Breschdling/PI3CM/BOM/BOM.xls

Designator | Value | Quantity | Manufacturer | Part No.: | Mouser PN | Footprint
C7 | 220uF/16V | 1 | Nichicon | RL81C221MDN1KX | 647-RL81C221MDN1KX | 8x8P3,5
C11,12,13,15,16,17,18,20,21,22,31,32,33,34,35,36,37,38 | 22uF | 18 | Murata | GRM21BR61A226ME51L | 81-GRM21BR61A226ME1L | 0805
C1,3,5,10,27 | 10uF | 5 | Murata | GRM21BR61C106KE15K | 81-GRM21BR61C106KE5K | 0805
C2,8,19,23,40 | 2.2uF | 5 | Murata | GRM21BR71A225KA01K | 81-GRM21BR71A225KA1K | 0805
C4,9,26,28,29,30 | 100nF | 6 | Murata | GRM188R71H104KA93D | 81-GRM39X104K50D | 0603
C6,14 | 10nF | 2 | Murata | GRM188R71H103KA01D | 81-GRM39X103K50D | 0603
C24,25 | 33pF | 2 | Murata | GRM1885C1H330JA01D | 81-GRM39C330J50 | 0603
C39 | 4n7 | 1 | Murata | GRM21AR72D472KW01D | 81-GRM21AR72D472KW1D | 0805
R15,16,24 | 0R | 3 | Panasonic | ERJ-3GEY0R00V | 667-ERJ-3GEY0R00V | 0603
R17,18 | 50mR | 2 | Susumu | RL1220T-R050-G | 754-RL1220T-R050-G | 0805
R22,23,29,30,31,32,33,34,35,36 | 22R | 10 | Bourns | CR0603-FX-22R0ELF | 652-CR0603FX-22R0ELF | 0603
R2 | 100R | 1 | Bourns | CR0603-FX-1000ELF | 652-CR0603FX-1000ELF | 0603
R7 | 470R | 1 | Bourns | CR0603-FX-4700ELF | 652-CR0603FX-4700ELF | 0603
R25,37,43,44 | 1k5 | 4 | Bourns | CR0603-FX-1501ELF | 652-CR0603FX-1501ELF | 0603
R10,12,20 | 10k | 3 | Bourns | CR0603-FX-1002ELF | 652-CR0603FX-1002ELF | 0603
R6,8 | 30k | 2 | Bourns | CR0603-FX-3002ELF | 652-CR0603FX-3002ELF | 0603
R11 | 33k2 | 1 | Bourns | CR0603-FX-3322ELF | 652-CR0603FX-3322ELF | 0603
R13,14 | 68k | 2 | Bourns | CR0603-FX-6802ELF | 652-CR0603FX-6802ELF | 0603
R1,3,4,5,9,19,21,26,27,28,38,39,40,41,42 | 100k | 15 | Bourns | CR0603-FX-1003ELF | 652-CR0603-FX-103ELF | 0603
R45 | 0R47 | 1 | TE con | 2-2176054-4 | 279-2-2176054-4 | 0805
R46 | 2R7 | 1 | Panasonic | ERJ-3GEYJ2R7V | 667-ERJ-3GEYJ2R7V | 0603
L1,2 | 2.2uH | 2 | Tayo Yuden | NS10165T2R2NNV | 963-NS10165T2R2NNV | 10,1x10,1
Y1 | 6MHz | 1 | Epson | CA-301 6.000M-C:PBFREE | 732-CA3016.000M-CPB | Radial
T1 | Si3421DV | 1 | Vishay | SI3421DV-T1-GE3 | 78-SI3421DV-T1-GE3 | TSOP-6
T2,4,5,6,7 | 2N7002 | 5 | Fairchild | 2N7002KW | 512-2N7002KW | SOT-323-3
D1 | SMBJ5.0CA | 1 | ST micro | SMBJ5.0CA | 511-SMBJ5.0CA | SMB
D2 | BAT54C | 1 | Fairchild | BAT54CWT1G | 512-BAT54CWT1G | SOT-323
D3 | SBR3U20SA | 1 | Diodes | SBR3U20SA-13 | 621-SBR3U20SA-13 | SMA-2
D4 | RB095BM-30 | 1 | Rohm | RB095BM-30TL | 755-RB095BM-30TL | TO-252-3
D5 | 82402305 | 1 | Wuerth | 82402305 | 710-82402305 | SOT-23-6L
IC1 | AP7361C-25ER | 1 | Diodes | AP7361C-25E-13
IC3 | AP7361C-18ER | 1 | Diodes | AP7361C-18E-13
IC2 | TPS563219A | 1 | Texas Instr. | TPS563219ADDFR | 595-TPS563219ADDFR | SOT-23-8
IC4 | ACT2813 | 1 | Active Semi | ACT2813QY-T | 107-ACT2813QY-T | QFN-20
IC5 | TUSB2046B | 1 | Texas Instr. | TUSB2046BVFRG4 | 595-TUSB2046BVFRG4 | LQFP-32
IC6 | AP2331 | 1 | Diodes | AP2331SA-7 | 621-AP2331SA-7 | SOT23-3
IC7 | TPS2044B | 1 | Texas Instr. | TPS2044BDR | 595-TPS2044BDR | SOIC-16
F1 | MF-MSMF250/16X | 1 | Bourns | MF-MSMF260 | 652-MF-MSMF260-2 | 1812
J1,3 | PH2x1_2.54 | 2 | 3M | 961102-6404-AR
J2 | PH3x1_2.54 | 1 | 3M | 961103-6404-AR
X1 | DDR2_SODIMM | 1 | TE con | 1473005-4 | 571-1473005-4 | DDR-SODIMM
X2 | PH20x2_2.54 | 1 | Omron | XG8W-2041
X3 | PH2x8_2.54 | 1 | Omron | XG8W-1641
X4 | PH5x1_2.54 | 1 | 3M | 961105-6404-AR
X5 | PH7x1_2.54 | 1 | 3M | 961107-6404-AR
X6,7 | PH2x1_2.54 | 2 | 3M | 961102-6404-AR
X9 | PH9x1_2.54 female | 1 | Harwin | M20-7820942 | 855-M20-7820942
X8,11,12,13,14 | PH4x1_2.54 | 5 | 3M | 961104-6404-AR
X10 | FFC pitch | 1 | Omron | XF2L-2035-1A | 653-XF2L-2035-1A
M1 | RPI3_CM_lite | 1 | Raspberry Pi | RPI-COMPUTE3-LT |  | DDR-SODIMM
