Breschdling/PI3CM/Schema/PI3CM.pdf

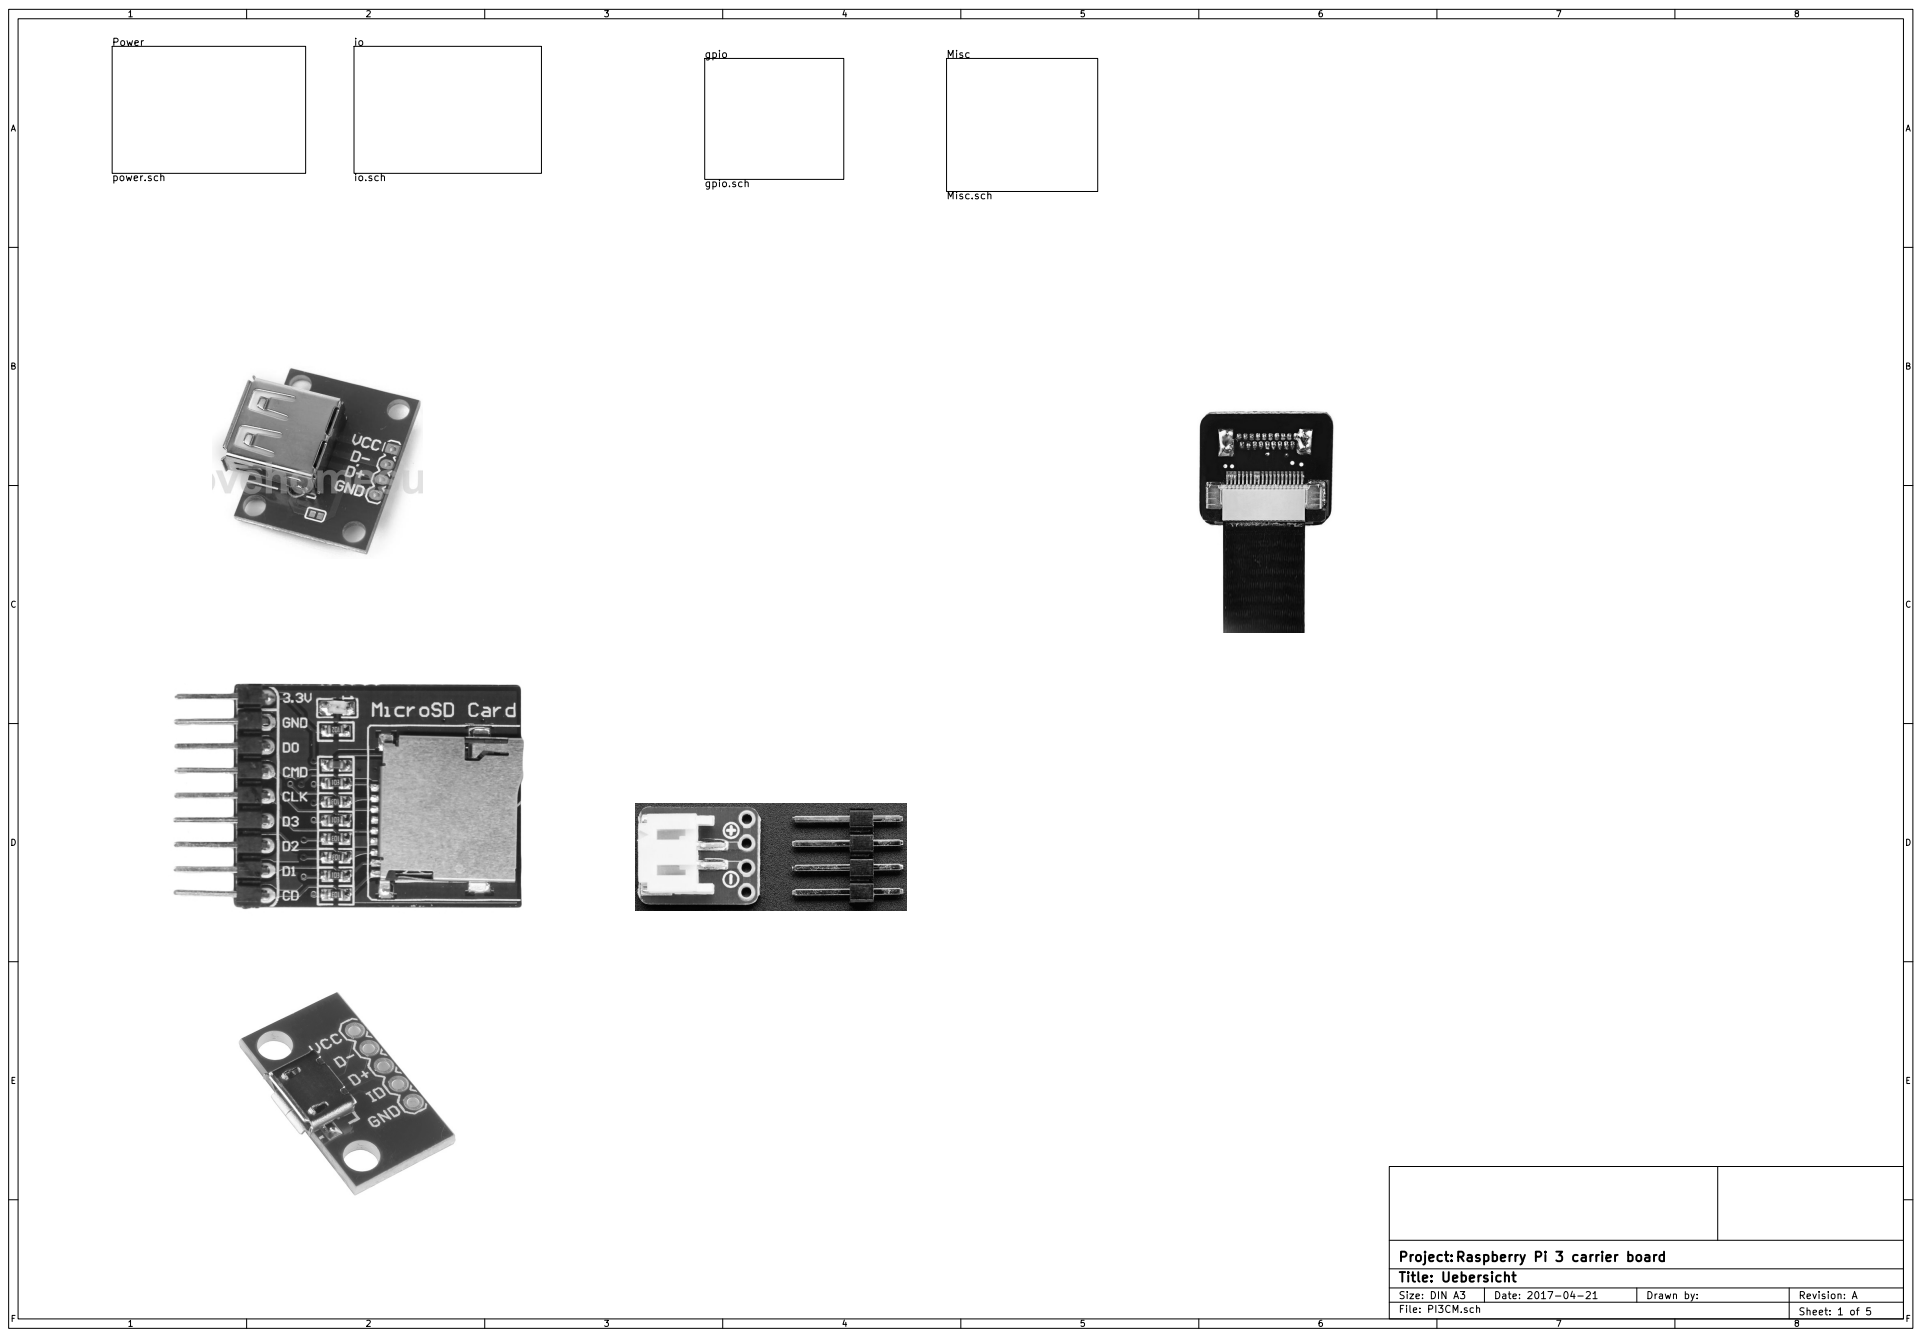
[picture p1: page 1]

Tobias Fetsch Sheet: 1 of 5 Title: Uebersicht File: PI3CM.sch Project:

Date: 2017-04-21 | Revision: A | F Size: DIN A3

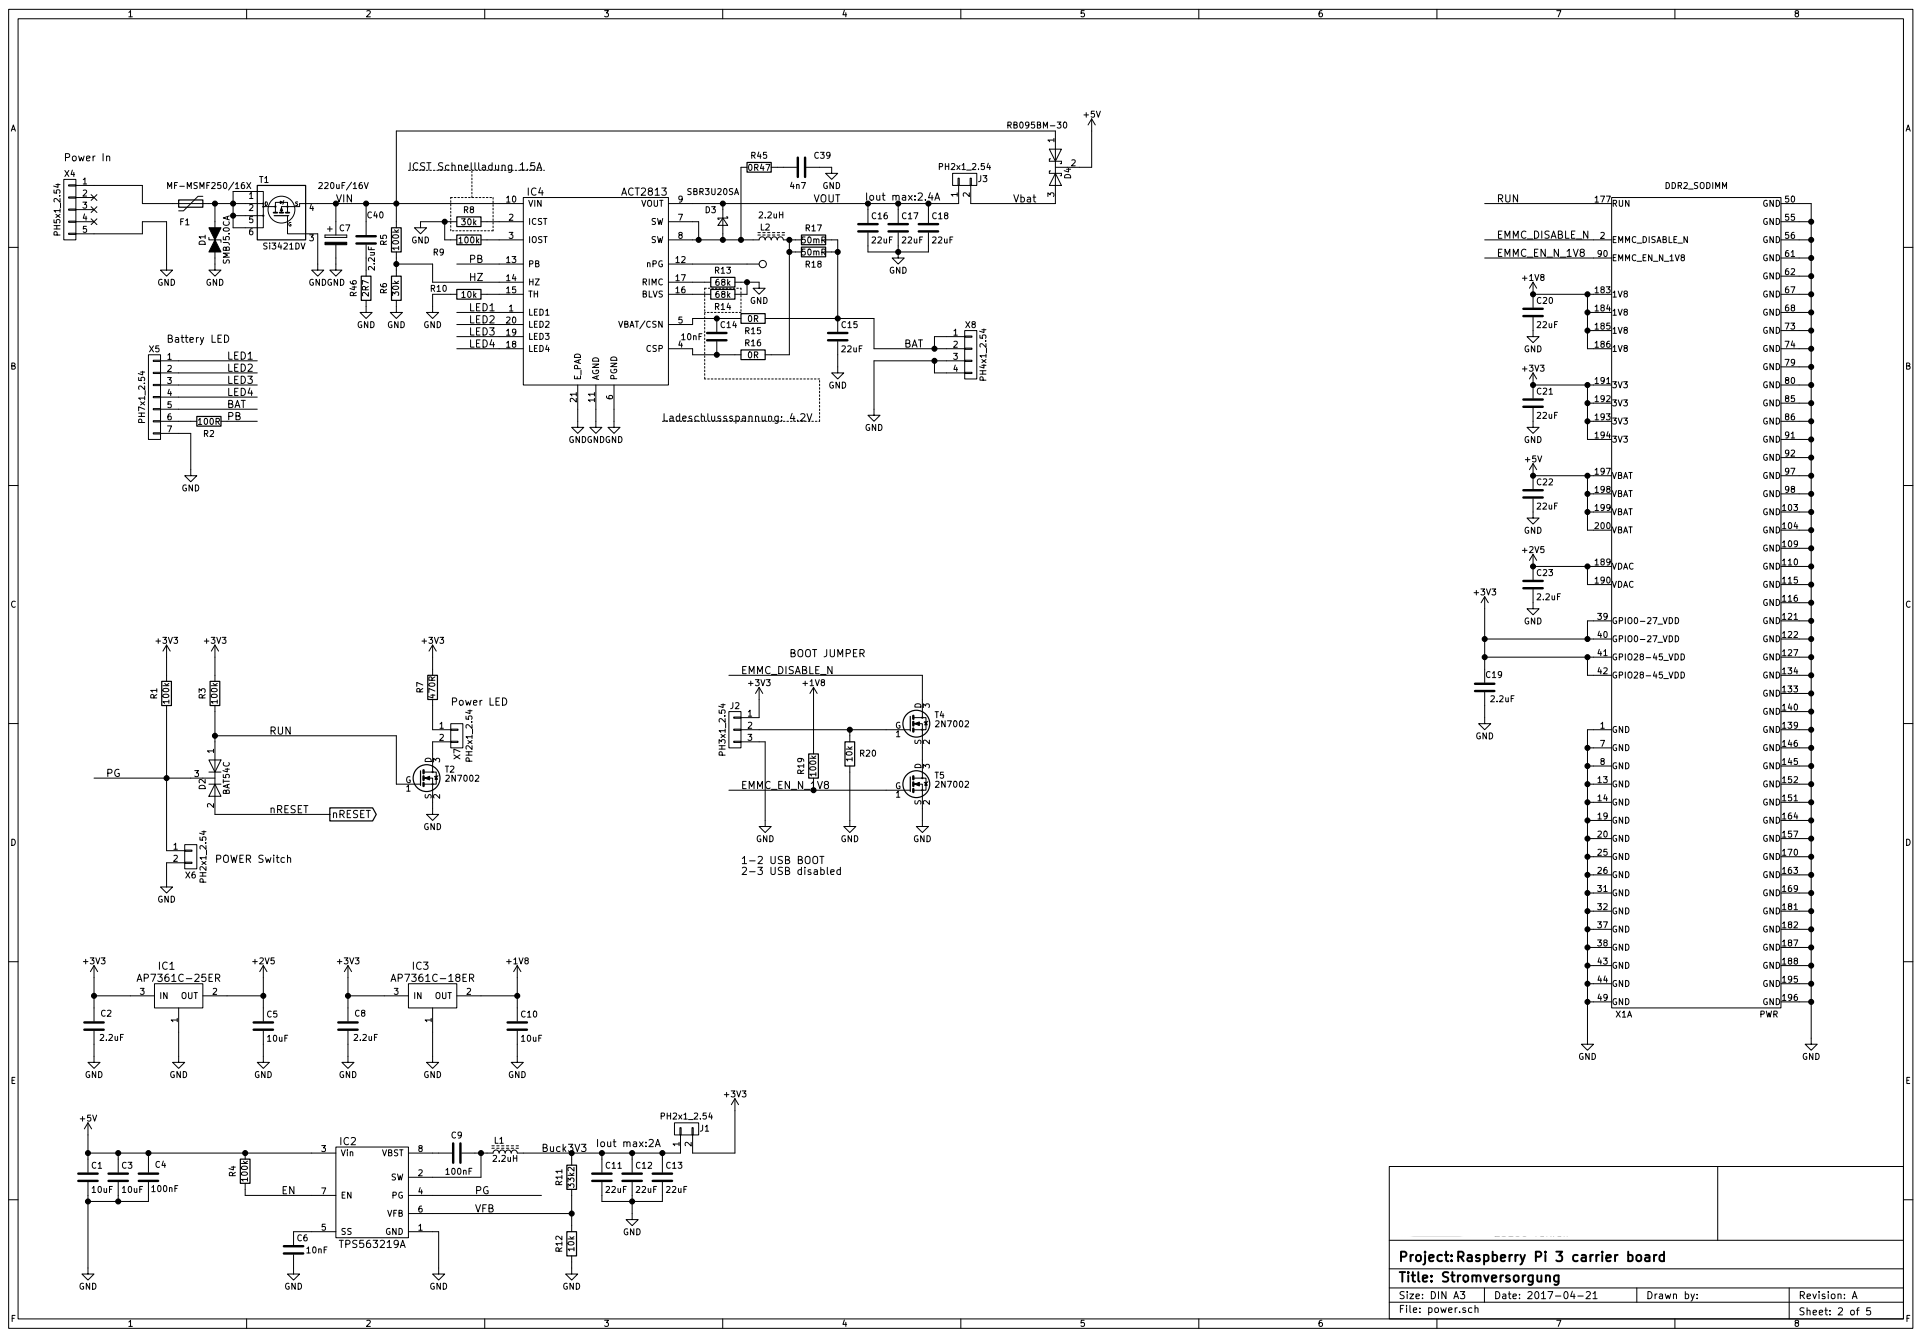
[picture p2: page 2]

6 SW 7 SW 8 VOUT 9 VIN 10

4 | 2 | 4 | | ICST 2 | R17

EMMC_EN_N_1V8 EMMC_DISABLE_N
22uF GND GND GND GND

IC2 TPS563219A | C11

File: power.sch Project: | Tobias Fetsch

Sheet: 2 of 5 Title: Stromversorgung

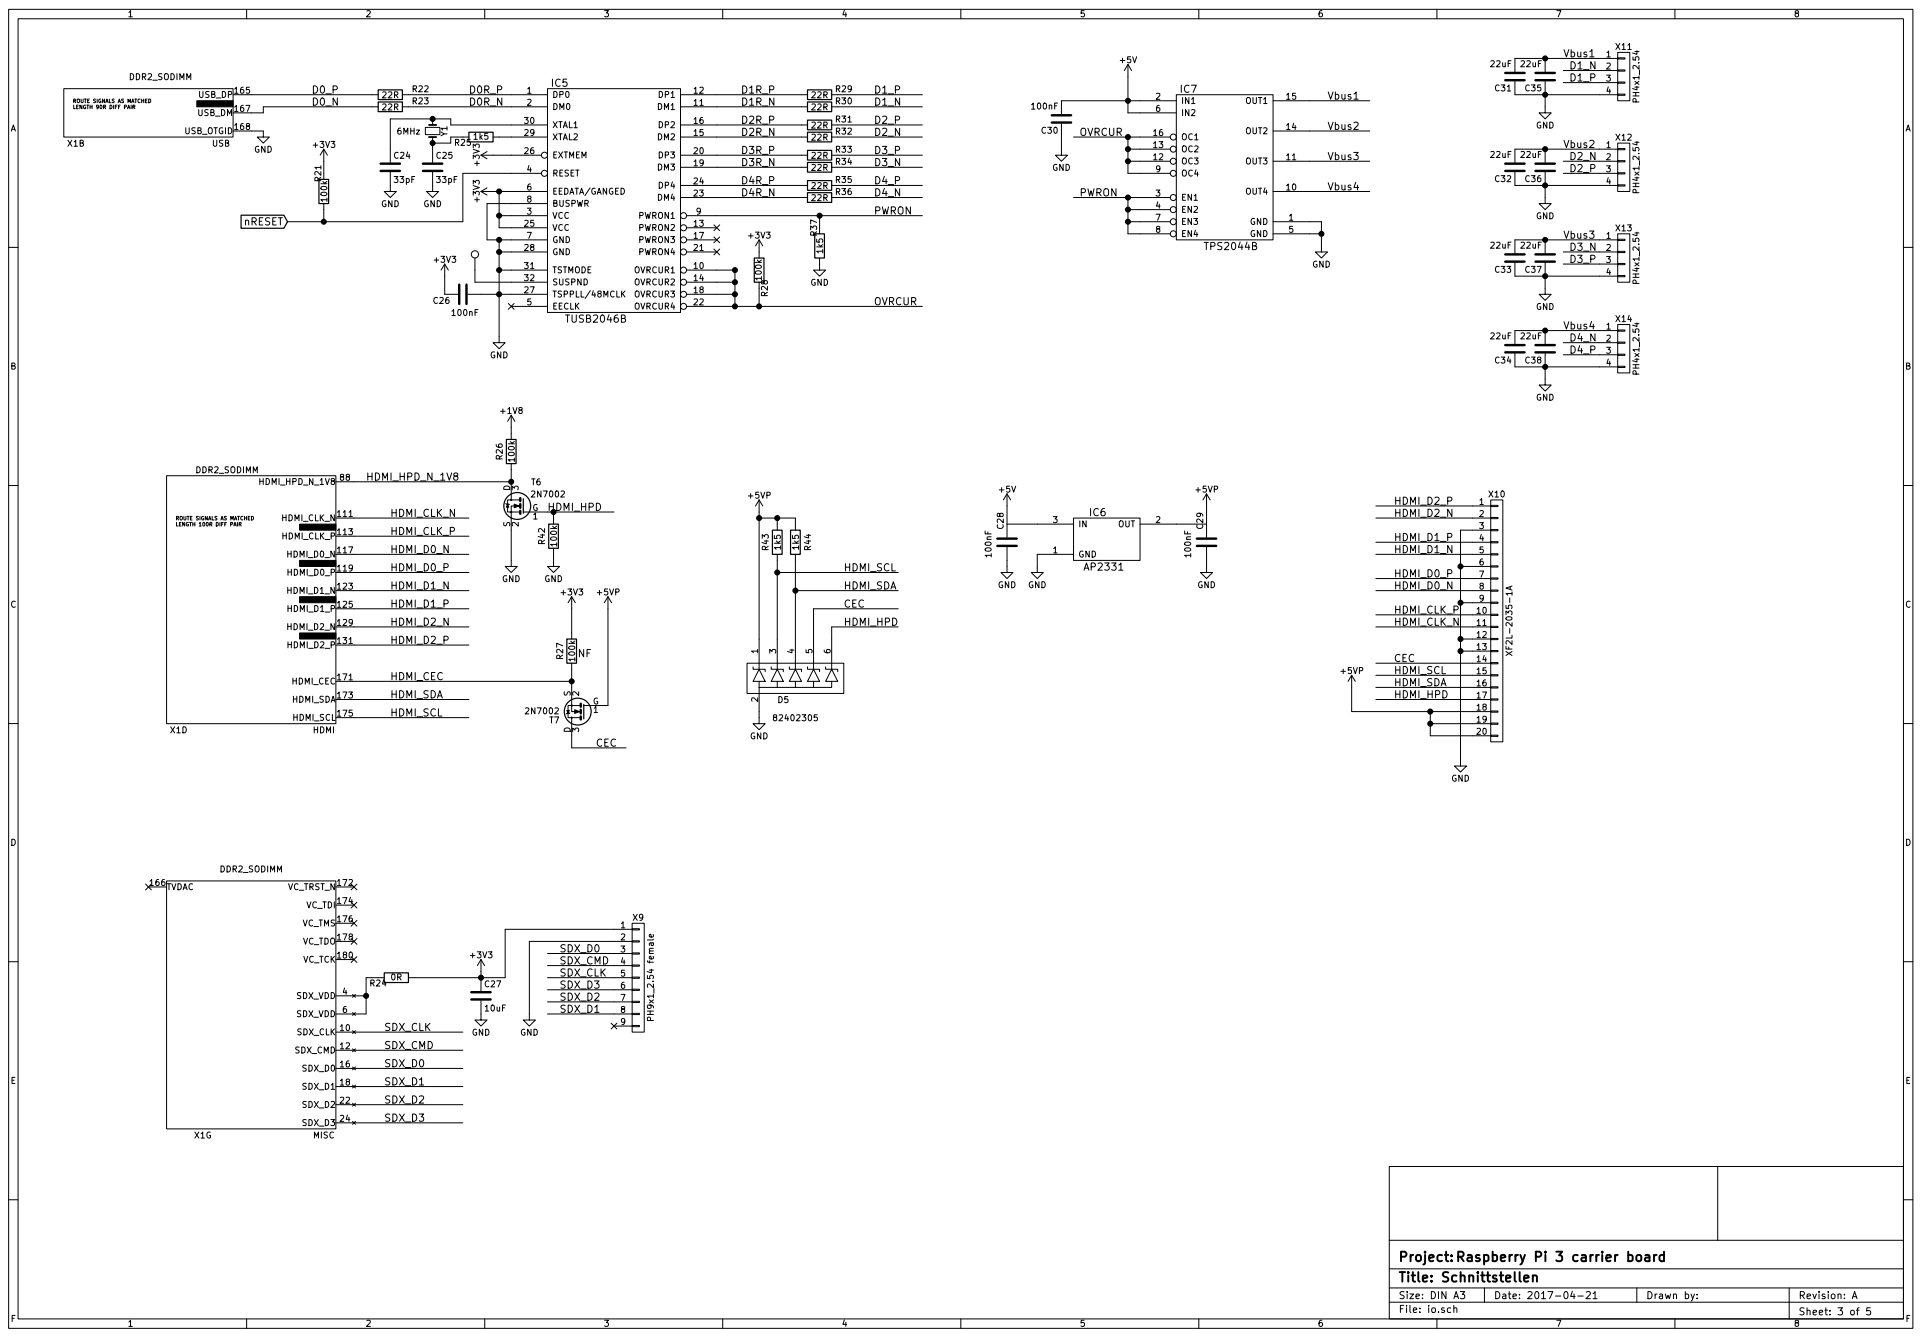
[picture p3: page 3]

0R | 10uF GND SDX_CLK | 6

Sheet: 3 of 5 Title: Schnittstellen

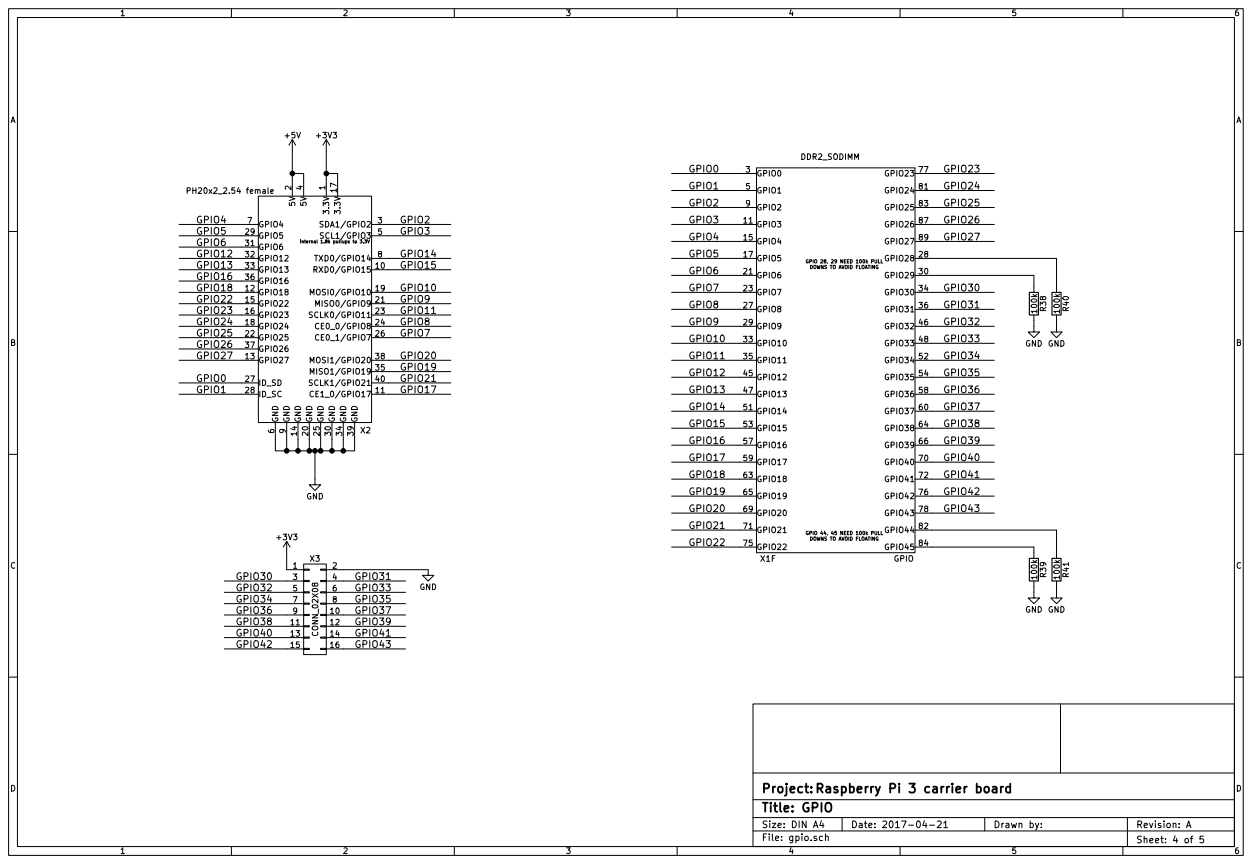
[picture p4: page 4]

DOWNS TO AVOID FLOATING

No.22, Ln.68, Qiaoxing Rd
23156 Taiwan Xindian, New Taipei city

Project:
Sheet: 4 of 5 Title: GPIO

Raspberry Pi 3 carrier board

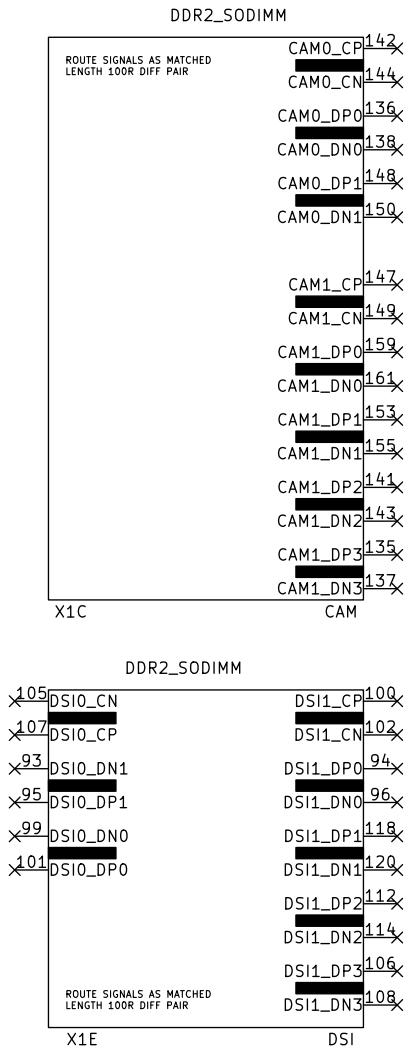
[picture p5: page 5]

DSI LENGTH 100R DIFF PAIR

No.22, Ln.68, Qiaoxing Rd
