Breschdling/PI3CM/PI3CM.kicad_pcb

## KiCad design PI3CM.kicad_pcb (2021-03-07)

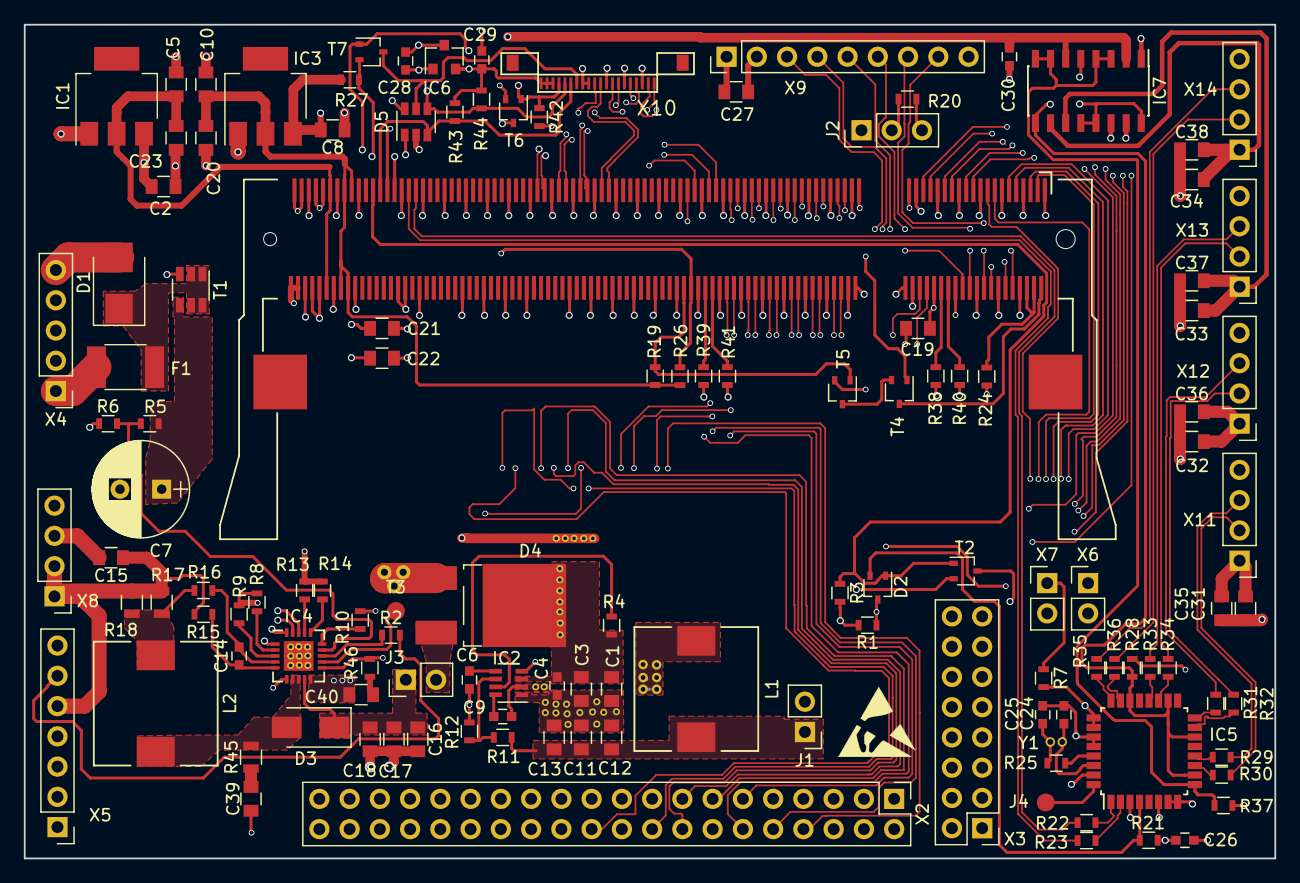
[picture p6: board PI3CM.kicad_pcb from above]

Board: 4 copper layers, 105.0 x 70.0 mm, 127 parts (0 on the bottom side), 143 nets.

Parts:
C1, C3, C5, C10, C27: 10uF; C_0805
C2, C8, C19, C23, C40: 2.2uF; C_0805
C4, C9, C26, C28, C29, C30: 100nF; C_0603
C6, C14: 10nF; C_0603
C7: 220uF/16V; CP_Radial_D8.0mm_P3.50mm
C11, C12, C13, C15, C16, C17, C18, C20, C21, C22, C31, C32, C33, C34, C35, C36, C37, C38: 22uF; C_0805
C24, C25: 33pF; C_0603
C39: 4n7; C_0805
D1: SMBJ5.0CA; D_SMB_Standard
D2: BAT54C; SOT-323_SC-70
D3: SBR3U20SA; D_SMA_Standard
D4: RB095BM-30; TO-252-2Lead
D5: 82402305; SOT-23-6
F1: MF-MSMF250/16X; L_1812
IC1: AP7361C-25ER; SOT-223
IC2: TPS563219A; SOT-23-8
IC3: AP7361C-18ER; SOT-223
IC4: ACT2813; QFN-20-1EP_4x4mm_Pitch0.5mm
IC5: TUSB2046B; LQFP-32_7x7mm_Pitch0.8mm
IC6: AP2331; SOT-23
IC7: TPS2044B; SOIC-16_3.9x9.9mm_Pitch1.27mm
J1, J3: PH2x1_2.54; Pin_Header_Straight_1x02_Pitch2.54mm
J2: PH3x1_2.54; Pin_Header_Straight_1x03_Pitch2.54mm
J4: TEST_1P; Measurement_Point_Round-SMD-Pad_Small
L1, L2: 2.2uH; Choke_SMD_10.1x10.1_H6.5
R1, R3, R4, R5, R9, R19, R21, R26, R27, R28, R38, R39, R40, R41, R42: 100k; R_0603
R2: 100R; R_0603
R6, R8: 30k; R_0603
R7: 470R; R_0603
R10, R12, R20: 10k; R_0603
R11: 33k2; R_0603
R13, R14: 68k; R_0603
R15, R16, R24: 0R; R_0603
R17, R18: 50mR; R_0805
R22, R23, R29, R30, R31, R32, R33, R34, R35, R36: 22R; R_0603
R25, R37, R43, R44: 1k5; R_0603
R45: 0R47; R_0805
R46: 2R7; R_0603
T1: Si3421DV; TSOT-23-6_MK06A
T2, T4, T5, T6, T7: 2N7002; SOT-323_SC-70
T3: Test; Measurement_Point_Round-SMD-Pad_Small
X1: DDR2_SODIMM; Conn_TE-DDR2-SODIMM-0.6-200P
X2: PH20x2_2.54 female; Pin_Header_Straight_2x20_Pitch2.54mm
X3: CONN_02X08; Pin_Header_Straight_2x08_Pitch2.54mm
X4: PH5x1_2.54; Pin_Header_Straight_1x05_Pitch2.54mm
X5: PH7x1_2.54; Pin_Header_Straight_1x07_Pitch2.54mm
X6, X7: PH2x1_2.54; Pin_Header_Straight_1x02_Pitch2.54mm
X8, X11, X12, X13, X14: PH4x1_2.54; Pin_Header_Straight_1x04_Pitch2.54mm
X9: PH9x1_2.54 female; Socket_Strip_Straight_1x09_Pitch2.54mm
X10: XF2L-2035-1A
Y1: 6MHz; Crystal_Round_d3.1mm_Vertical

Connections:
+1V8: C10.1, C20.1, IC3.2, R19.2, R26.1, X1.183, X1.184, X1.185, X1.186
+2V5: C5.1, C23.1, IC1.2, X1.189, X1.190
+3V3: C2.2, C8.2, C19.2, C21.1, C26.2, C27.1, IC1.3, IC3.3, IC5.3, IC5.6, IC5.25, IC5.26, J1.2, J2.1, R1.2, R3.2, R7.2, R21.1, R24.2, R27.1, R28.2, X1.39, X1.40, X1.41, X1.42, X1.191, X1.192, X1.193, X1.194, X2.1, X2.17, X3.1, X9.1
+5V: C1.1, C3.1, C4.2, C22.1, C28.2, C30.2, D4.2, IC2.3, IC6.3, IC7.2, IC7.6, R4.2, X1.197, X1.198, X1.199, X1.200, X2.2, X2.4
+5VP: C29.2, D5.1, IC6.2, R43.1, R44.1, T7.1, X10.18, X10.19, X10.20
/Power/BAT: C15.1, R15.1, R17.1, R18.1, X5.5, X8.1, X8.2
/Power/Buck3V3: C11.1, C12.1, C13.1, J1.1, L1.2, R11.2
/Power/EMMC_DISABLE_N: T4.3, X1.2
/Power/EMMC_EN_N_1V8: R19.1, T5.1, X1.90
/Power/EN: IC2.7, R4.1
/Power/HZ: IC4.14, R5.1, R6.2
/Power/LED1: IC4.1, X5.1
/Power/LED2: IC4.20, X5.2
/Power/LED3: IC4.19, X5.3
/Power/LED4: IC4.18, X5.4
/Power/PB: IC4.13, R2.1
/Power/PG: D2.3, IC2.4, R1.1, X6.1
/Power/RUN: D2.1, R3.1, T2.1, X1.177
/Power/VFB: IC2.6, R11.1, R12.2
/Power/VIN: C7.1, C40.2, D4.1, IC4.10, R5.2, T1.4
/Power/VOUT: C16.1, C17.1, C18.1, D3.1, IC4.9, J3.1
/Power/Vbat: D4.3, J3.2
/gpio/GPIO0: X1.3, X2.27
/gpio/GPIO1: X1.5, X2.28
/gpio/GPIO2: X1.9, X2.3
/gpio/GPIO3: X1.11, X2.5
/gpio/GPIO4: X1.15, X2.7
/gpio/GPIO5: X1.17, X2.29
/gpio/GPIO6: X1.21, X2.31
/gpio/GPIO7: X1.23, X2.26
/gpio/GPIO8: X1.27, X2.24
/gpio/GPIO9: X1.29, X2.21
/gpio/GPIO10: X1.33, X2.19
/gpio/GPIO11: X1.35, X2.23
/gpio/GPIO12: X1.45, X2.32
/gpio/GPIO13: X1.47, X2.33
/gpio/GPIO14: X1.51, X2.8
/gpio/GPIO15: X1.53, X2.10
/gpio/GPIO16: X1.57, X2.36
/gpio/GPIO17: X1.59, X2.11
/gpio/GPIO18: X1.63, X2.12
/gpio/GPIO19: X1.65, X2.35
/gpio/GPIO20: X1.69, X2.38
/gpio/GPIO21: X1.71, X2.40
/gpio/GPIO22: X1.75, X2.15
/gpio/GPIO23: X1.77, X2.16
/gpio/GPIO24: X1.81, X2.18
/gpio/GPIO25: X1.83, X2.22
/gpio/GPIO26: X1.87, X2.37
/gpio/GPIO27: X1.89, X2.13
/gpio/GPIO30: X1.34, X3.3
/gpio/GPIO31: X1.36, X3.4
/gpio/GPIO32: X1.46, X3.5
/gpio/GPIO33: X1.48, X3.6
/gpio/GPIO34: X1.52, X3.7
/gpio/GPIO35: X1.54, X3.8
/gpio/GPIO36: X1.58, X3.9
/gpio/GPIO37: X1.60, X3.10
/gpio/GPIO38: X1.64, X3.11
/gpio/GPIO39: X1.66, X3.12
/gpio/GPIO40: X1.70, X3.13
/gpio/GPIO41: X1.72, X3.14
/gpio/GPIO42: X1.76, X3.15
/gpio/GPIO43: X1.78, X3.16
/io/CEC: D5.5, T7.3, X10.14
/io/D0R_N: IC5.2, R23.1
/io/D0R_P: IC5.1, R22.1
/io/D0_N: R23.2, X1.167
/io/D0_P: R22.2, X1.165
/io/D1R_N: IC5.11, R30.2
/io/D1R_P: IC5.12, R29.2
/io/D1_N: R30.1, X11.2
/io/D1_P: R29.1, X11.3
/io/D2R_N: IC5.15, R32.2
/io/D2R_P: IC5.16, R31.2
/io/D2_N: R32.1, X12.2
/io/D2_P: R31.1, X12.3
/io/D3R_N: IC5.19, R34.2
/io/D3R_P: IC5.20, R33.2
/io/D3_N: R34.1, X13.2
/io/D3_P: R33.1, X13.3
/io/D4R_N: IC5.23, R36.2
/io/D4R_P: IC5.24, R35.2
/io/D4_N: R36.1, X14.2
/io/D4_P: R35.1, X14.3
/io/HDMI_CEC: R27.2, T7.2, X1.171
/io/HDMI_CLK_N: X1.111, X10.11
/io/HDMI_CLK_P: X1.113, X10.10
/io/HDMI_D0_N: X1.117, X10.8
/io/HDMI_D0_P: X1.119, X10.7
/io/HDMI_D1_N: X1.123, X10.5
/io/HDMI_D1_P: X1.125, X10.4
/io/HDMI_D2_N: X1.129, X10.2
/io/HDMI_D2_P: X1.131, X10.1
/io/HDMI_HPD: D5.6, R42.1, T6.1, X10.17
/io/HDMI_HPD_N_1V8: R26.2, T6.3, X1.88
/io/HDMI_SCL: D5.3, R43.2, X1.175, X10.15
/io/HDMI_SDA: D5.4, R44.2, X1.173, X10.16
/io/OVRCUR: IC5.10, IC5.14, IC5.18, IC5.22, IC7.9, IC7.12, IC7.13, IC7.16, R28.1
/io/PWRON: IC5.9, IC7.3, IC7.4, IC7.7, IC7.8, R37.1
/io/SDX_CLK: X1.10, X9.5
/io/SDX_CMD: X1.12, X9.4
/io/SDX_D0: X1.16, X9.3
/io/SDX_D1: X1.18, X9.8
/io/SDX_D2: X1.22, X9.7
/io/SDX_D3: X1.24, X9.6
/io/Vbus1: C31.2, C35.2, IC7.15, X11.1
/io/Vbus2: C32.2, C36.2, IC7.14, X12.1
/io/Vbus3: C33.2, C37.2, IC7.11, X13.1
/io/Vbus4: C34.2, C38.2, IC7.10, X14.1
GND: C1.2, C2.1, C3.2, C4.1, C5.2, C6.2, C7.2, C8.1, C10.2, C11.2, C12.2, C13.2, C15.2, C16.2, C17.2, C18.2, C19.1, C20.2, C21.2, C22.2, C23.2, C24.2, C25.2, C26.1, C27.2, C28.1, C29.1, C30.1, C31.1, C32.1, C33.1, C34.1, C35.1, C36.1, C37.1, C38.1, C39.1, D1.2, D5.2, IC1.1, IC2.1, IC3.1, IC4.6, IC4.11, IC4.21, IC5.7, IC5.8, IC5.27, IC5.28, IC5.31, IC6.1, IC7.1, IC7.5, J2.3, R6.1, R8.2, R9.2, R10.2, R12.1, R13.1, R14.1, R20.1, R37.2, R38.2, R39.2, R40.2, R41.2, R42.2, R46.1, T1.3, T2.2, T5.2, T6.2, X1.1, X1.7, X1.8, X1.13, X1.14, X1.19, X1.20, X1.25, X1.26, X1.31, X1.32, X1.37, X1.38, X1.43, X1.44, X1.49, X1.50, X1.55, X1.56, X1.61, X1.62, X1.67, X1.68, X1.73, X1.74, X1.79, X1.80, X1.85, X1.86, X1.91, X1.92, X1.97, X1.98, X1.103, X1.104, X1.109, X1.110, X1.115, X1.116, X1.121, X1.122, X1.127, X1.133, X1.134, X1.139, X1.140, X1.145, X1.146, X1.151, X1.152, X1.157, X1.163, X1.164, X1.168, X1.169, X1.170, X1.181, X1.182, X1.187, X1.188, X1.195, X1.196, X2.6, X2.9, X2.14, X2.20, X2.25, X2.30, X2.34, X2.39, X3.2, X4.5, X5.7, X6.2, X8.3, X8.4, X9.2, X10.3, X10.6, X10.9, X10.12, X10.13, X11.4, X12.4, X13.4, X14.4
unnamed: C6.1, IC2.5
unnamed: C9.1, IC2.2, L1.1
unnamed: C9.2, IC2.8
unnamed: C14.1, IC4.5, R15.2
unnamed: C14.2, IC4.4, R16.2
unnamed: C24.1, IC5.30, Y1.1
unnamed: C25.1, R25.1, Y1.2
unnamed: C39.2, R45.1
unnamed: C40.1, R46.2
unnamed: D1.1, F1.1, T1.1, T1.2, T1.5, T1.6
unnamed: D3.2, IC4.7, IC4.8, L2.1, R45.2
unnamed: F1.2, X4.1
unnamed: IC4.2, R8.1
unnamed: IC4.3, R9.1
unnamed: IC4.12, T3.1
unnamed: IC4.15, R10.1
unnamed: IC4.16, R14.2
unnamed: IC4.17, R13.2
unnamed: IC5.29, R25.2
unnamed: IC5.32, J4.1
unnamed: J2.2, R20.2, T4.1
unnamed: L2.2, R16.1, R17.2, R18.2
unnamed: R2.2, X5.6
unnamed: R7.1, X7.1
unnamed: R24.1, X1.4, X1.6
unnamed: R38.1, X1.30
unnamed: R39.1, X1.84
unnamed: R40.1, X1.28
unnamed: R41.1, X1.82
unnamed: T2.3, X7.2
unnamed: T4.2, T5.3
nRESET: D2.2, IC5.4, R21.2
