Breschdling/PI3CM/(threads)

Thread 1 (2021-03-07):

Footprint IC4

Breschdling, 2021-03-07:
Check and resolve the footprint of IC4

Thread 2 (2021-03-07):

Footprint X10

Breschdling, 2021-03-07:
Check and resolve footprint issue with the connector.

Thread 5 (2021-03-07):

Improve reset circuit

Breschdling, 2021-03-07:
Add a delay to the reset circuit of at least 1ms. RC network (15k, 1uF)
